nico33410/esp32-switch-pro/schematic/wiring_diagram.html

# ESP32 Pro Controller

// SCHÉMA DE CÂBLAGE COMPLET — v3.0

🔵 MCP23017 I²C @ 0x20 — 16 BOUTONS

Port A — GPA0→GPA7

PIN MCP | DEFINE | BOUTON
GPA0 | MCP_BTN_A | A
GPA1 | MCP_BTN_B | B
GPA2 | MCP_BTN_X | X
GPA3 | MCP_BTN_Y | Y
GPA4 | MCP_BTN_L | L
GPA5 | MCP_BTN_R | R
GPA6 | MCP_BTN_ZL | ZL
GPA7 | MCP_BTN_ZR | ZR

Port B — GPB0→GPB7

PIN MCP | DEFINE | BOUTON
GPB0 | MCP_BTN_MINUS | −
GPB1 | MCP_BTN_PLUS | +
GPB2 | MCP_DPAD_LEFT | ◀ D-PAD LEFT
GPB3 | MCP_DPAD_RIGHT | ▶ D-PAD RIGHT
GPB4 | MCP_BTN_HOME | 🏠 HOME
GPB5 | MCP_BTN_CAPTURE | ⬤ CAPTURE
GPB6 | MCP_DPAD_UP | ▲ D-PAD UP
GPB7 | MCP_DPAD_DOWN | ▼ D-PAD DOWN

Câblage MCP23017 : SDA → GPIO21 | SCL → GPIO22 | VDD (pin9) → 3.3V | VSS (pin10) → GND
RESET (pin18) → 3.3V | A0/A1/A2 (pin15-16-17) → GND (adresse 0x20)
Pull-up I²C intégrés sur le module (résistances 472 = 4.7kΩ vers VCC)
Tous boutons : une borne sur GPx, l'autre sur GND

🟢 GPIO Directs ESP32 INPUT_PULLUP

Clics joysticks

GPIO | DEFINE | FONCTION
GPIO 25 | LSTICK_BTN_PIN | 🕹️ Clic gauche
GPIO 26 | RSTICK_BTN_PIN | 🕹️ Clic droit

Lignes directes (hors connecteurs SP16)

GPIO | DEFINE | FONCTION
GPIO 16 | PIN_CONFIG_MODE | GND au démarrage → mode WiFi
GPIO 17–19 | — | Réservés, non lus par le firmware

Boutons vers GND — pull-up interne ESP32

🟡 Joysticks Analogiques ADC1 uniquement

Joystick Gauche

GPIO | DEFINE | SIGNAL
GPIO 34 | STICK_LX_PIN | LX — ADC1_CH6
GPIO 35 | STICK_LY_PIN | LY — ADC1_CH7
3.3V | VCC joystick
GND | GND joystick

Joystick Droit

GPIO | DEFINE | SIGNAL
GPIO 32 | STICK_RX_PIN | RX — ADC1_CH4
GPIO 33 | STICK_RY_PIN | RY — ADC1_CH5
3.3V | VCC joystick
GND | GND joystick

⚠ GPIO 34/35 : entrées uniquement, sans pull-up interne
GPIO25/26 sont utilisés en entrées numériques pour les clics L3/R3.

💡 LEDs SORTIES GPIO

LEDs Joueur (1-4)

GPIO | DEFINE | LED
GPIO 27 | LED_1 | LED 1
GPIO 14 | LED_2 | LED 2
GPIO 12 | LED_3 | LED 3
GPIO 13 | LED_4 | LED 4

LED HOME

GPIO | DEFINE | LED
GPIO 15 | LED_HOME_PIN | LED HOME

LEDs avec résistance intégrée 3-6V
Anode (+) → GPIO | Cathode (−) → GND

📳 Vibration — BC547 GPIO 4 → TRANSISTOR → 5V

PATTE BC547 | CONNEXION
Base (centre) | GPIO 4 via R 1kΩ
Collecteur (gauche) | Moteur → 5V
Émetteur (droite) | GND

5V ──────┬──────────┐
Cathode [Moteur]
1N4007 │
Anode │
└──────────┤
Collecteur
GPIO4─R1kΩ─Base [BC547]
Émetteur
│
GND

BC547 vue face plate : C — B — E
Diode 1N4007 en parallèle sur le moteur
Cathode (bague) → 5V | Anode → Collecteur

🔋 Batterie & I²C ADC + BUS

Batterie LiPo

GPIO | DEFINE | SIGNAL
GPIO 36 | BATTERY_PIN | Mesure tension

Diviseur 1:2
VBAT → R1 10kΩ → GPIO36 → R2 10kΩ → GND
4.2V LiPo → 2.1V sur GPIO36
⚠ GPIO 36 : input only

Bus I²C

GPIO | DEFINE | → MCP
GPIO 21 | I2C_SDA | SDA → pin 13
GPIO 22 | I2C_SCL | SCL → pin 12

Pull-up I²C intégrés sur le module MCP23017

🔌 Faisceaux — JST 8 broches vers SP16-9F 6 × CONNECTEURS RONDS

Le tableau donne le chemin complet fonction → JST de la carte → connecteur rond SP16 → numéro de fil. Les fils 3 à 6 sont normalisés entre les faisceaux : un même numéro porte les fonctions regroupées ci-dessous. La broche 9 reste réservée. Vérifier le repère mécanique 1 du SP16 avant sertissage.

J1 → SP16-1 — Direction

JST carte | SP16 / fil | SIGNAL
1 | 1 | 3.3V
2 | 2 | GND
3 | 6 | D-Pad bas (MCP GPB7)
4 | 4 | D-Pad haut (MCP GPB6)
5 | 3 | D-Pad droite (MCP GPB3)
6 | 5 | D-Pad gauche (MCP GPB2)
7–8 | 7–8 | Réservé
— | 9 | Réservé

J2 → SP16-2 — Système

JST carte | SP16 / fil | SIGNAL
1 | 1 | 3.3V
2 | 2 | GND
3 | 6 | Capture (MCP GPB5)
4 | 3 | Home (MCP GPB4)
5 | 4 | Plus (MCP GPB1)
6 | 5 | Minus (MCP GPB0)
7–8 | 7–8 | Réservé
— | 9 | Réservé

J3 → SP16-3 — ABXY

JST carte | SP16 / fil | SIGNAL
1 | 1 | 3.3V
2 | 2 | GND
3 | 3 | A (MCP GPA0)
4 | 6 | B (MCP GPA1)
5 | 4 | X (MCP GPA2)
6 | 5 | Y (MCP GPA3)
7–8 | 7–8 | Réservé
— | 9 | Réservé

J4 → SP16-4 — Gâchettes

JST carte | SP16 / fil | SIGNAL
1 | 1 | 3.3V
2 | 2 | GND
3 | 5 | L (MCP GPA4)
4 | 4 | R (MCP GPA5)
5 | 6 | ZL (MCP GPA6)
6 | 3 | ZR (MCP GPA7)
7–8 | 7–8 | Réservé
— | 9 | Réservé

J5 → SP16-5 — Joystick droit

JST carte | SP16 / fil | SIGNAL
1 | 1 | 3.3V
2 | 2 | GND
3 | 4 | RX → GPIO32
4 | 3 | RY → GPIO33
5 | 5 | R3 → GPIO26
6–8 | 6–8 | Réservé
— | 9 | Réservé

J6 → SP16-6 — Joystick gauche

JST carte | SP16 / fil | SIGNAL
1 | 1 | 3.3V
2 | 2 | GND
3 | 3 | LX → GPIO34
4 | 4 | LY → GPIO35
5 | 5 | L3 → GPIO25
6–8 | 6–8 | Réservé
— | 9 | Réservé

GPIO16–19 et les cinq LEDs restent sur des fils directs dans le PCB actuel. Ils ne font pas partie de ces six faisceaux SP16.

📋 Récapitulatif complet — tous GPIO ESP32

GPIO | DEFINE | FONCTION | TYPE
GPIO 21 | I2C_SDA | I²C SDA → MCP23017 | I2C
GPIO 22 | I2C_SCL | I²C SCL → MCP23017 | I2C
GPIO 25 | LSTICK_BTN_PIN | 🕹️ Clic joystick gauche | INPUT_PULLUP
GPIO 26 | RSTICK_BTN_PIN | 🕹️ Clic joystick droit | INPUT_PULLUP
GPIO 16 | PIN_CONFIG_MODE | Mode configuration au démarrage | INPUT_PULLUP
GPIO 17 | — | Réservé | —
GPIO 18 | — | Réservé | —
GPIO 19 | — | Réservé | —
GPIO 34 | STICK_LX_PIN | Joystick gauche X | ADC1_CH6
GPIO 35 | STICK_LY_PIN | Joystick gauche Y | ADC1_CH7

GPIO | DEFINE | FONCTION | TYPE
GPIO 32 | STICK_RX_PIN | Joystick droit X | ADC1_CH4
GPIO 33 | STICK_RY_PIN | Joystick droit Y | ADC1_CH5
GPIO 27 | LED_1 | LED joueur 1 | OUTPUT
GPIO 14 | LED_2 | LED joueur 2 | OUTPUT
GPIO 12 | LED_3 | LED joueur 3 | OUTPUT
GPIO 13 | LED_4 | LED joueur 4 | OUTPUT
GPIO 15 | LED_HOME_PIN | LED HOME | OUTPUT
GPIO 4 | VIBRATION_PIN | Moteur vibrant → BC547 | OUTPUT
GPIO 36 | BATTERY_PIN | Mesure batterie | ADC1_CH0

🗺️ Légende

GPIO | Digital input/output
ADC | Entrée analogique 12-bit
I²C | Bus données I²C
MCP | Pin MCP23017
3.3V | Alimentation 3.3V
5V | Alimentation 5V (LiPo Rider)
GND | Masse commune

// ESP32 PRO CONTROLLER v3.0 — LEDs résistance intégrée — BC547 low-side switch — Pull-up I²C sur module MCP
