nico33410/esp32-switch-pro/(commit log)

2026-03-01 premier pcb
    [esp32-switch.kicad_pcb, esp32-switch.kicad_sch]
2026-03-01 mise à jour du schema
    [esp32-switch.kicad_pcb, esp32-switch.kicad_sch]
2026-03-01 Mise à jour du pcb
    [esp32-switch.kicad_pcb]
2026-03-01 changment des pates des leds
    [esp32-switch.kicad_pcb, esp32-switch.kicad_sch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]
2026-03-01 suppression de fichiers inutiles
2026-03-12 changement de pcb
    [esp32-switch.kicad_pcb]
2026-03-13 Ajout de texte
    [esp32-switch.kicad_pcb]
2026-11-11 Ajout de la configuration dynamique
